suman1shrestha/LED-cube/LED_CUBE/3.jpg

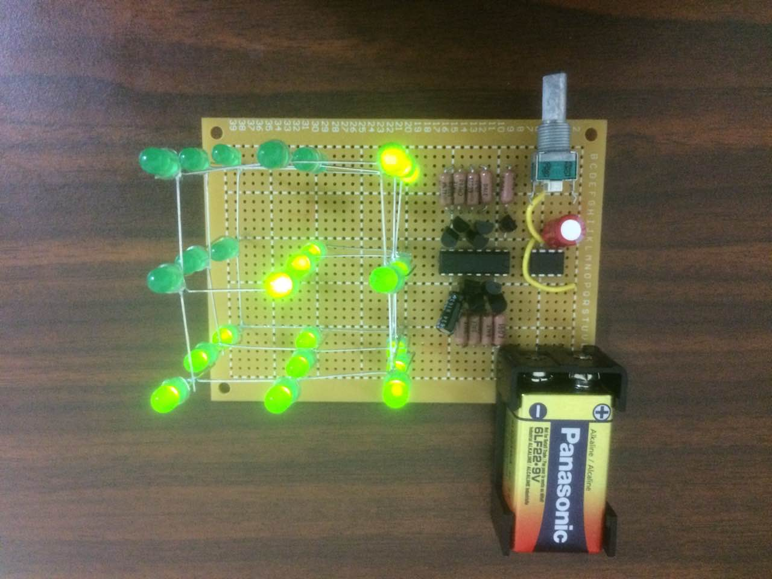
LED_CUBE/3.jpg
