suman1shrestha/LED-cube/LED_CUBE/2.jpg

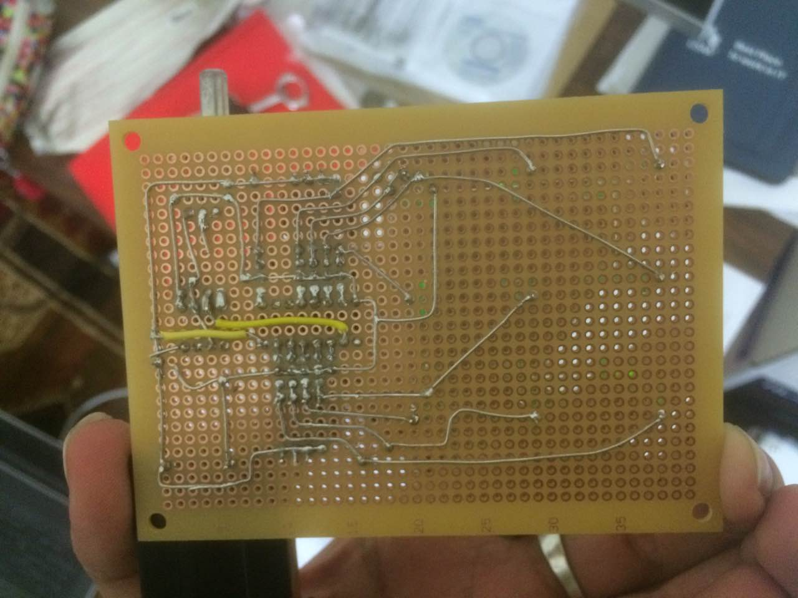
LED_CUBE/2.jpg
