suman1shrestha/LED-cube/LED_CUBE/led_cube_schematic.brd

## EAGLE design LED_CUBE/led_cube_schematic.brd (2017-01-07)

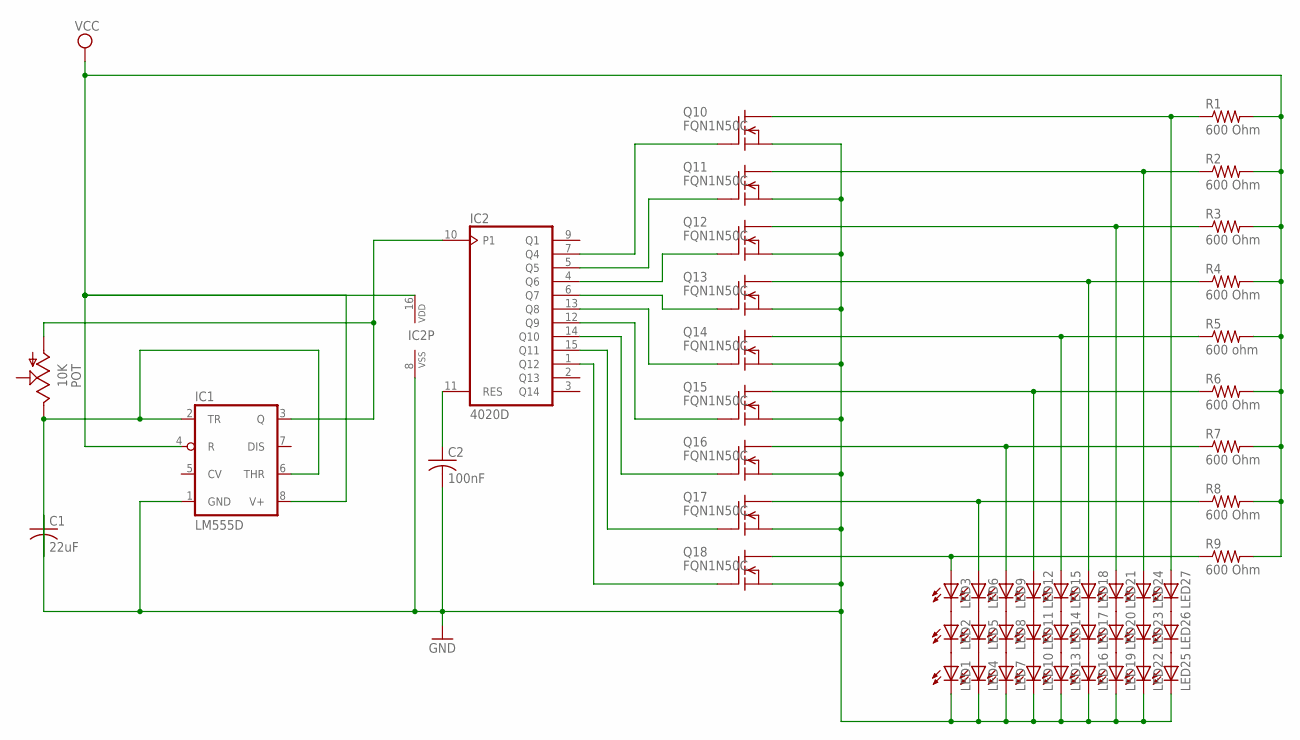
[picture p11: schematic led_cube_schematic.sch]

Parts:
C1: 22uF; C075-032X103
C2: 100nF; C075-032X103
IC1: LM555D; SO08
IC2: 4020D; SO16
LED1, LED2, LED3, LED4, LED5, LED6, LED7, LED8, LED9, LED10, LED11, LED12, LED13, LED14, LED15, LED16, LED17, LED18, LED19, LED20, LED21, LED22, LED23, LED24, LED25, LED26, LED27: LEDB155; Q62902-B155
POT: 10K; LI15
Q10, Q11, Q12, Q13, Q14, Q15, Q16, Q17, Q18: FQN1N50C; TO92
R1, R2, R3, R4, R6, R7, R8, R9: 600 Ohm; 0309/12
R5: 600 ohm; 0309/12

Connections:
GND: C1.1, C2.2, IC1.1 (GND), IC2.8 (VSS), LED1.K (C), LED4.K (C), LED7.K (C), LED10.K (C), LED13.K (C), LED16.K (C), LED19.K (C), LED22.K (C), LED25.K (C), Q10.3 (S), Q11.3 (S), Q12.3 (S), Q13.3 (S), Q14.3 (S), Q15.3 (S), Q16.3 (S), Q17.3 (S), Q18.3 (S)
unnamed: C1.2, IC1.2 (TR), IC1.6 (THR), POT.E
unnamed: IC2.1 (Q12), Q18.1 (G)
unnamed: IC1.3 (Q), IC2.10 (P1), POT.A
unnamed: IC2.15 (Q11), Q17.1 (G)
unnamed: C2.1, IC2.11 (RES)
unnamed: IC2.14 (Q10), Q16.1 (G)
unnamed: IC2.12 (Q9), Q15.1 (G)
unnamed: IC2.13 (Q8), Q14.1 (G)
unnamed: IC2.6 (Q7), Q13.1 (G)
unnamed: IC2.4 (Q6), Q12.1 (G)
unnamed: IC2.5 (Q5), Q11.1 (G)
unnamed: IC2.7 (Q4), Q10.1 (G)
unnamed: LED1.A, LED2.K (C)
unnamed: LED2.A, LED3.K (C)
unnamed: LED4.A, LED5.K (C)
unnamed: LED5.A, LED6.K (C)
unnamed: LED7.A, LED8.K (C)
unnamed: LED8.A, LED9.K (C)
unnamed: LED10.A, LED11.K (C)
unnamed: LED11.A, LED12.K (C)
unnamed: LED13.A, LED14.K (C)
unnamed: LED14.A, LED15.K (C)
unnamed: LED16.A, LED17.K (C)
unnamed: LED17.A, LED18.K (C)
unnamed: LED19.A, LED20.K (C)
unnamed: LED20.A, LED21.K (C)
unnamed: LED22.A, LED23.K (C)
unnamed: LED23.A, LED24.K (C)
unnamed: LED25.A, LED26.K (C)
unnamed: LED26.A, LED27.K (C)
unnamed: LED3.A, Q18.2 (D), R9.1
unnamed: LED6.A, Q17.2 (D), R8.1
unnamed: LED9.A, Q16.2 (D), R7.1
unnamed: LED12.A, Q15.2 (D), R6.1
unnamed: LED15.A, Q14.2 (D), R5.1
unnamed: LED18.A, Q13.2 (D), R4.1
unnamed: LED21.A, Q12.2 (D), R3.1
unnamed: LED24.A, Q11.2 (D), R2.1
unnamed: LED27.A, Q10.2 (D), R1.1
unnamed: R1.2, R2.2, R3.2, R4.2, R5.2, R6.2, R7.2, R8.2, R9.2
VCC: IC1.4 (R), IC1.8 (V+), IC2.16 (VDD)

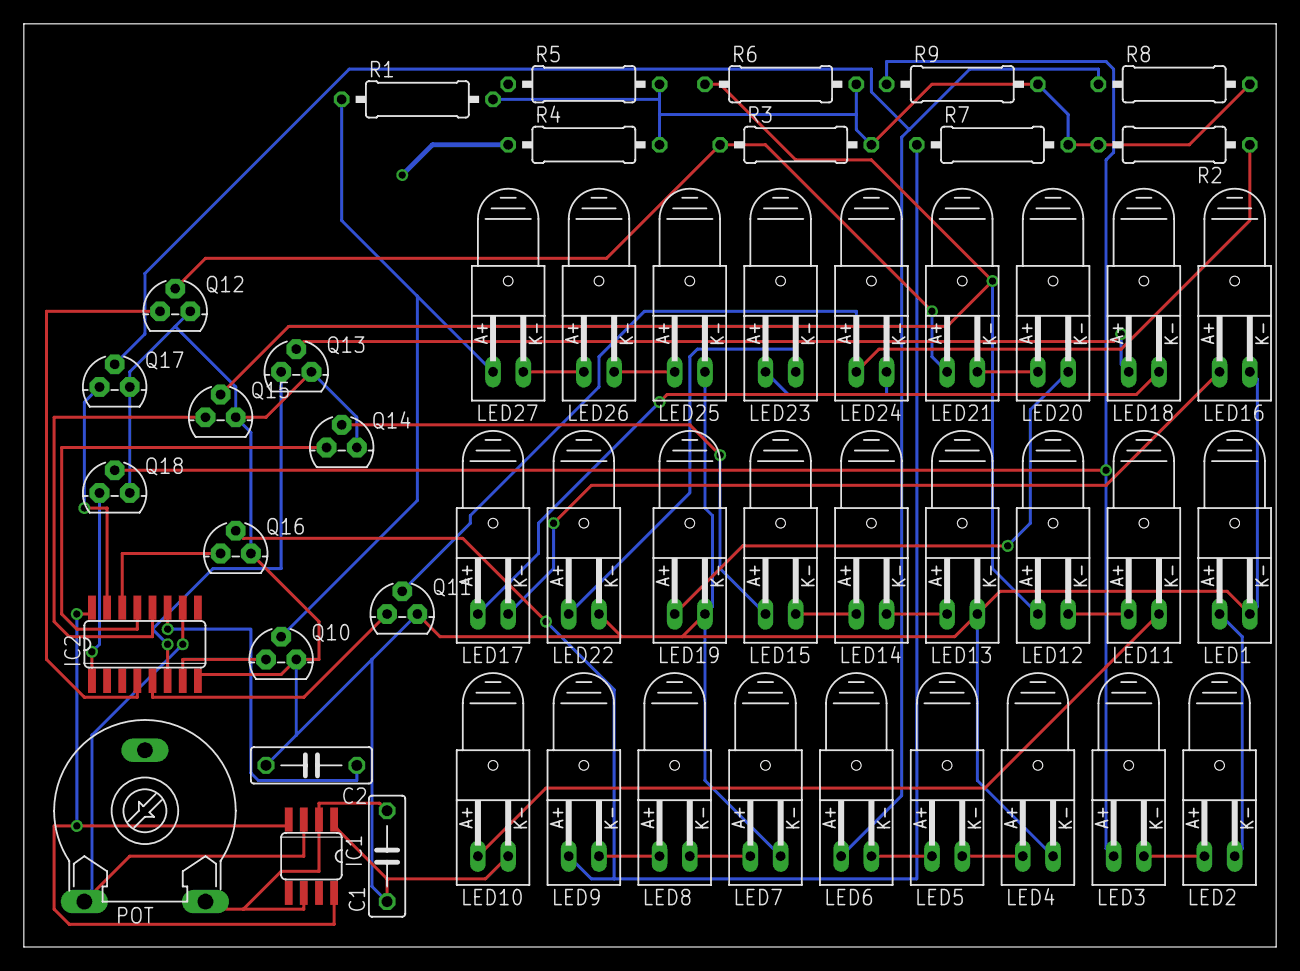
[picture p12: board led_cube_schematic.brd from above]

Board: 2 copper layers, 105.1 x 77.5 mm, 50 parts (0 on the bottom side), 42 nets.
